JQIamo/AOD_protector/AOD_protector-main/AOD_protector-main.kicad_pcb

## KiCad design AOD_protector-main/AOD_protector-main.kicad_pcb (2025-11-24)

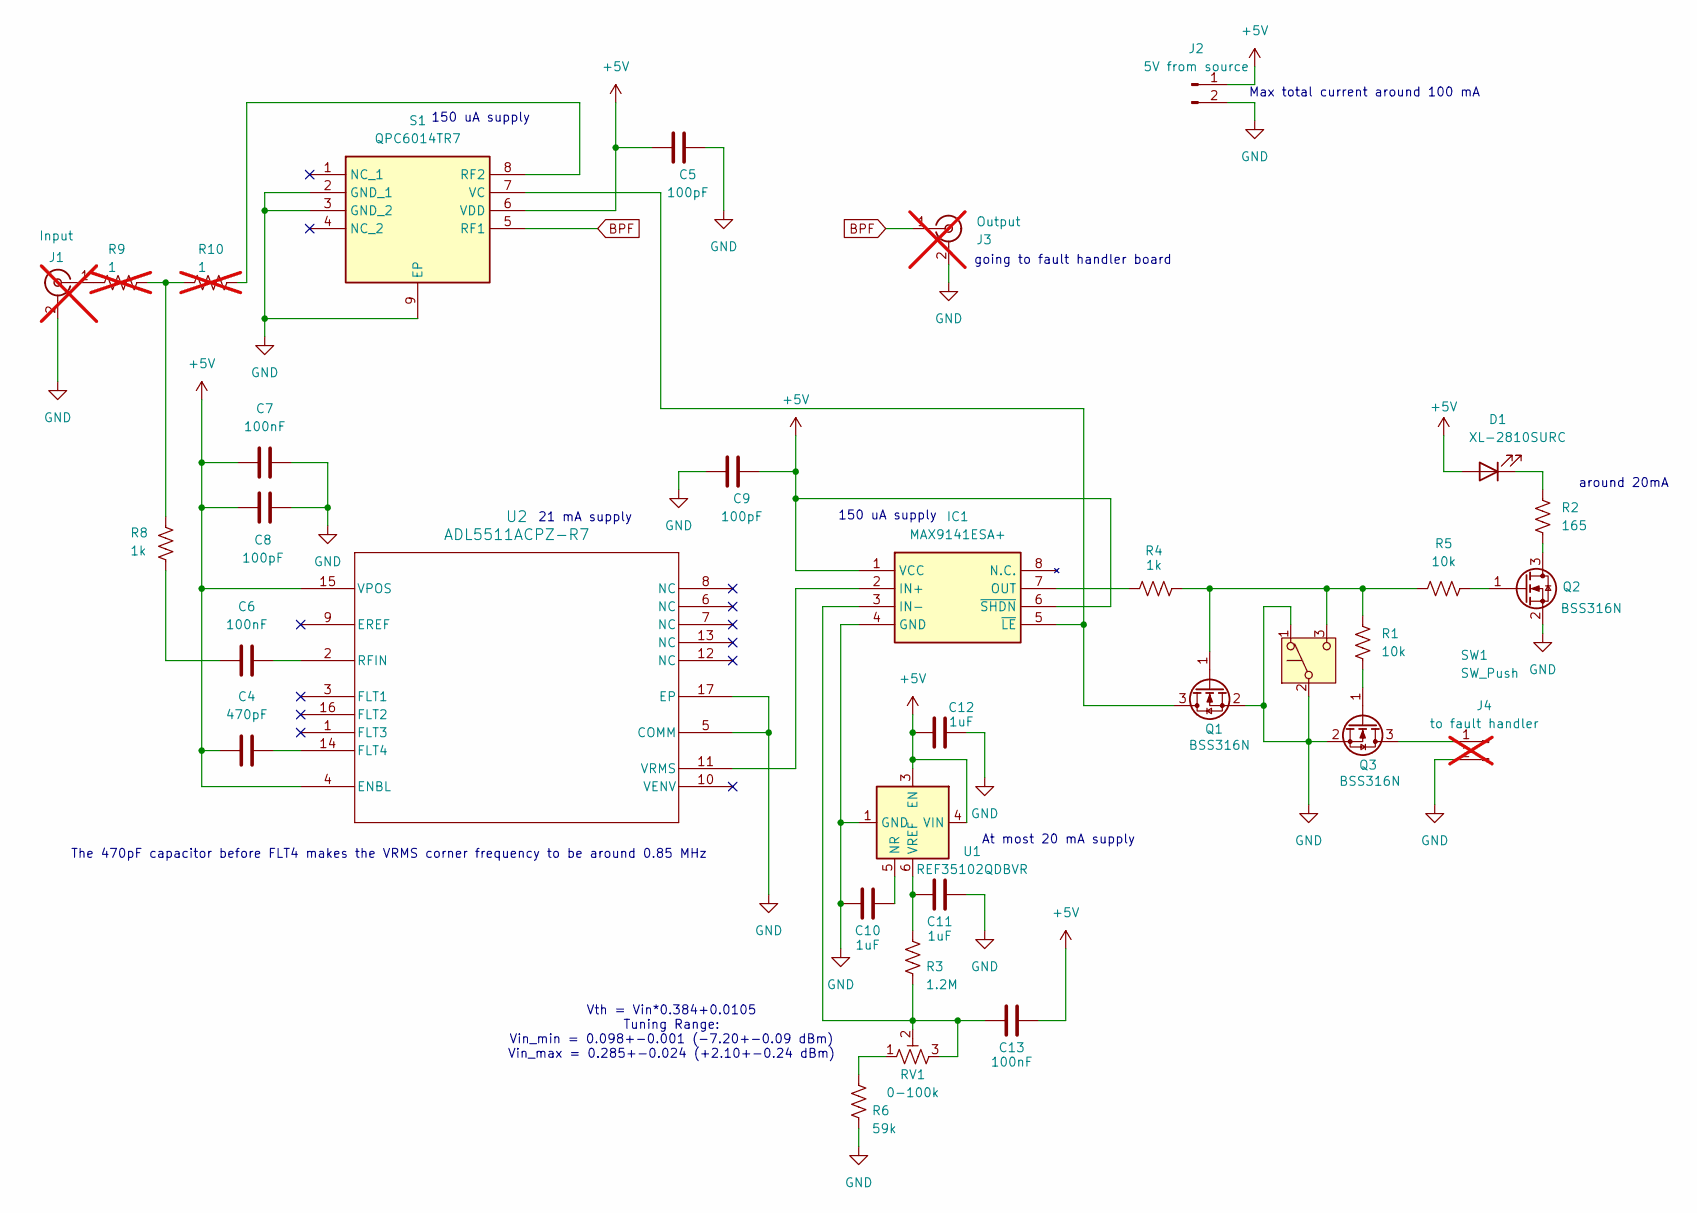
[picture p5: schematic AOD_protector-main.kicad_sch]

Parts:
C4: 470pF; C_0402_1005Metric; Part number CC0402FRNPO9BN471; JLCPCB Part C513551
C5, C8, C9: 100pF; C_0402_1005Metric; Part number CC0402FRNPO9BN101; JLCPCB Part C327198
C6, C7, C13: 100nF; C_0603_1608Metric; Part number CC0603JRX7R9BB104; JLCPCB Part C91183
C10, C11, C12: 1uF; C_0603_1608Metric; Part number CL10B105KB8NQNC; JLCPCB Part C5199872
D1: XL-2810SURC; LED-SMD_L3.5-W1.4-FD-1; Part number XL-2810SURC; JLCPCB Part C3646948
IC1: MAX9141ESA+; SOIC127P600X175-8N; Manufacturer_Part_Number MAX9141ESA+; Mouser Part Number 700-MAX9141ESA
J1: Input; BNC_Amphenol_031-6233_EdgeMount; Part number 031-6233; not fitted
J2: 5V from source; CONN-TH_2P-P2.54_MX128-2.54-GN01-02P-CU-Y-A; Part number MX128-2.54-02P-GN01-Cu-Y-A; JLCPCB Part C5188442
J3: Output; BNC_Amphenol_031-6233_EdgeMount; Part number 031-6233; not fitted
J4: to fault handler; PinHeader_1x02_P2.54mm_Vertical; not fitted
Q1, Q2, Q3: BSS316N; SOT-23; Part number BSS316N; JLCPCB Part C19829413
R1, R5: 10k; R_0402_1005Metric; Part number RT0402BRD0710KL; JLCPCB Part C190095
R2: 165; R_0603_1608Metric; Part number ARG03BTC1650; JLCPCB Part C5266122
R3: 1.2M; R_0603_1608Metric; Part number MCT0603MD1204BP500; JLCPCB Part C3933664
R4, R8: 1k; R_0402_1005Metric; Part number RT0402BRD071KL; JLCPCB Part C852624
R6: 59k; R_0402_1005Metric; Part number RT0402BRD0759KL; JLCPCB Part C852853
R9, R10: 1; R_0402_1005Metric; not fitted
RV1: 0-100k; RES-ADJ-TH_3296X; Part number 3296X-1-104LF; JLCPCB Part C49473
S1: QPC6014TR7; SON50P200X200X90-9N-D; Manufacturer_Part_Number QPC6014TR7; Mouser Part Number 772-QPC6014TR7
SW1: SW_Push; SW-TH_TK-6580B-2; Part number TK-6580B-2; JLCPCB Part C2689830
U1: REF35102QDBVR; SOT-23-6; Part number REF35102QDBVR; JLCPCB Part C6265001
U2: ADL5511ACPZ-R7; CP_16_22_ADI; Part number ADL5511ACPZ-R7; JLCPCB Part C579159

Connections:
+5V: C4.1, C5.1, C7.1, C8.1, C9.2, C12.2, C13.1, D1.2 (A), IC1.1 (VCC), IC1.6 (~SHDN), J2.1, S1.6 (VDD), U1.3 (EN), U1.4 (VIN), U2.4 (ENBL), U2.15 (VPOS)
BPF: J3.1 (In), S1.5 (RF1)
GND: C5.2, C7.2, C8.2, C9.1, C10.2, C11.1, C12.1, IC1.4 (GND), J1.2 (Ext), J2.2, J3.2 (Ext), J4.2, Q1.2 (S), Q2.2 (S), Q3.2 (S), R6.1, S1.2 (GND_1), S1.3 (GND_2), S1.9 (EP), SW1.1 (A), SW1.2 (B), U1.1 (GND), U1.2 (GND), U2.5 (COMM), U2.17 (EP)
unnamed: C6.1, R8.1
unnamed: D1.1 (K), R2.1
unnamed: IC1.2 (IN+), U2.11 (VRMS)
unnamed: C13.2, IC1.3 (IN-), R3.1, RV1.2, RV1.3
unnamed: IC1.7 (OUT), R4.1
unnamed: IC1.5 (~LE), Q1.3 (D), S1.7 (VC)
unnamed: J1.1 (In), R9.1
unnamed: J4.1, Q3.3 (D)
unnamed: Q1.1 (G), R1.1, R4.2, R5.2, SW1.3 (C)
unnamed: Q2.3 (D), R2.2
unnamed: Q2.1 (G), R5.1
unnamed: Q3.1 (G), R1.2
unnamed: R6.2, RV1.1
unnamed: R8.2, R9.2, R10.1
unnamed: R10.2, S1.8 (RF2)
unnamed: C10.1, U1.5 (NR)
unnamed: C11.2, R3.2, U1.6 (VREF)
unnamed: C4.2, U2.14 (FLT4)
unnamed: C6.2, U2.2 (RFIN)

Notes on the sheet:
At most 20 mA supply
21 mA supply
150 uA supply
Vth = Vin*0.384+0.0105 Tuning Range: Vin_min = 0.098+-0.001 (-7.20+-0.09 dBm) Vin_max = 0.285+-0.024 (+2.10+-0.24 dBm)
around 20mA
going to fault handler board
Max total current around 100 mA
The 470pF capacitor before FLT4 makes the VRMS corner frequency to be around 0.85 MHz

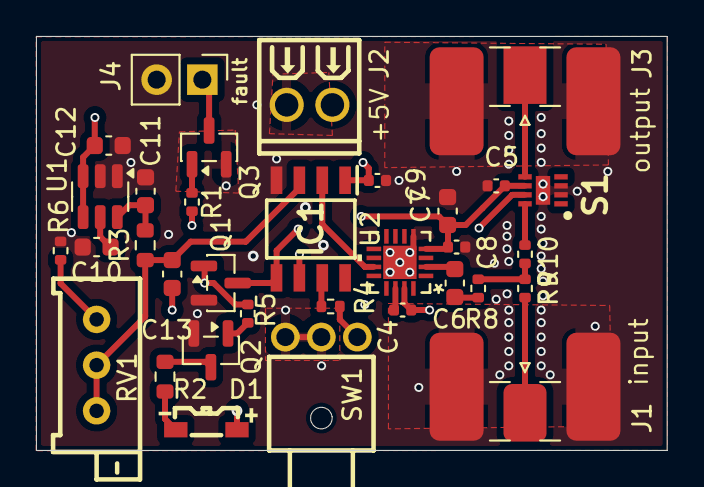
[picture p6: board AOD_protector-main.kicad_pcb from above]

Board: 4 copper layers, 35.0 x 23.0 mm, 33 parts (0 on the bottom side), 22 nets.
