JQIamo/AOD_protector/AOD_protector-fault_handler/AOD_protector-fault_handler.kicad_pcb

## KiCad design AOD_protector-fault_handler/AOD_protector-fault_handler.kicad_pcb (2025-11-17)

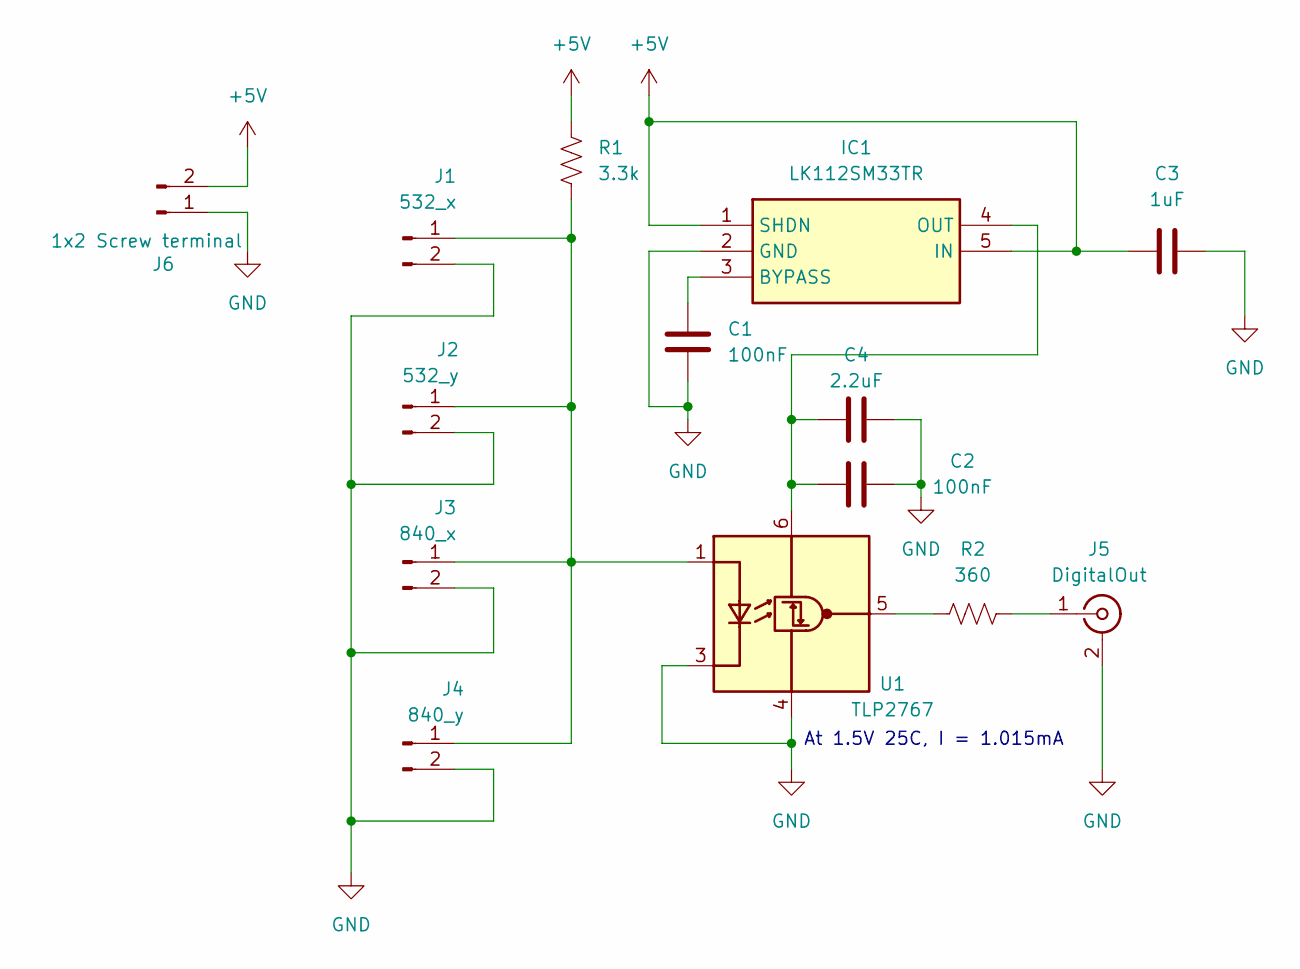
[picture p7: schematic AOD_protector-fault_handler.kicad_sch]

Parts:
C1, C2: 100nF; C_0603_1608Metric
C3: 1uF; C_0805_2012Metric
C4: 2.2uF; C_0805_2012Metric
IC1: LK112SM33TR; SOT95P280X145-5N; Mouser Part Number 511-LK112SM33
J1: 532_x; PinHeader_1x02_P2.54mm_Vertical
J2: 532_y; PinHeader_1x02_P2.54mm_Vertical
J3: 840_x; PinHeader_1x02_P2.54mm_Vertical
J4: 840_y; PinHeader_1x02_P2.54mm_Vertical
J5: DigitalOut; BNC_Amphenol_031-6233_EdgeMount; Manufacturer_Part_Number 031-6233
J6: 1x2 Screw terminal; CONN-TH_2P-P2.54_MX128-2.54-GN01-02P-CU-Y-A
R1: 3.3k; R_0603_1608Metric
R2: 360; R_0603_1608Metric
U1: TLP2767; SO-6L_10x3.84mm_P1.27mm; Manufacturer_Part_Number TLP2767

Connections:
+5V: C3.1, IC1.1 (SHDN), IC1.5 (IN), J6.2, R1.1
GND: C1.2, C2.2, C3.2, C4.2, IC1.2 (GND), J1.2, J2.2, J3.2, J4.2, J5.2 (Ext), J6.1, U1.3 (K), U1.4 (GND)
unnamed: C1.1, IC1.3 (BYPASS)
unnamed: C2.1, C4.1, IC1.4 (OUT), U1.6 (VDD)
unnamed: J1.1, J2.1, J3.1, J4.1, R1.2, U1.1 (A)
unnamed: J5.1 (In), R2.2
unnamed: R2.1, U1.5 (VO)

Notes on the sheet:
At 1.5V 25C, I = 1.015mA

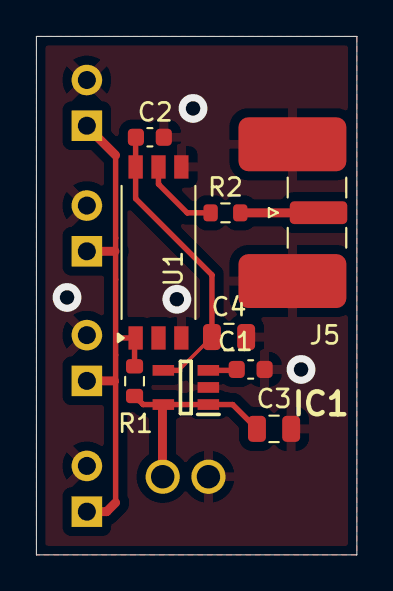
[picture p8: board AOD_protector-fault_handler.kicad_pcb from above]

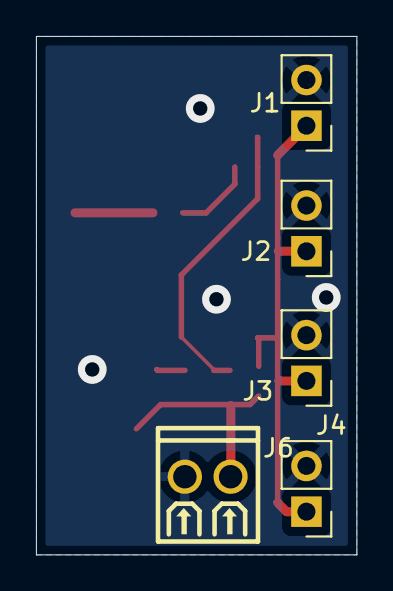
[picture p9: board AOD_protector-fault_handler.kicad_pcb from below]

Board: 2 copper layers, 17.8 x 28.8 mm, 14 parts (5 on the bottom side), 7 nets.
