JQIamo/AOD_protector/AOD_protector-power_board/AC_supply_module.kicad_pcb

## KiCad design AOD_protector-power_board/AC_supply_module.kicad_pcb (2025-11-17)

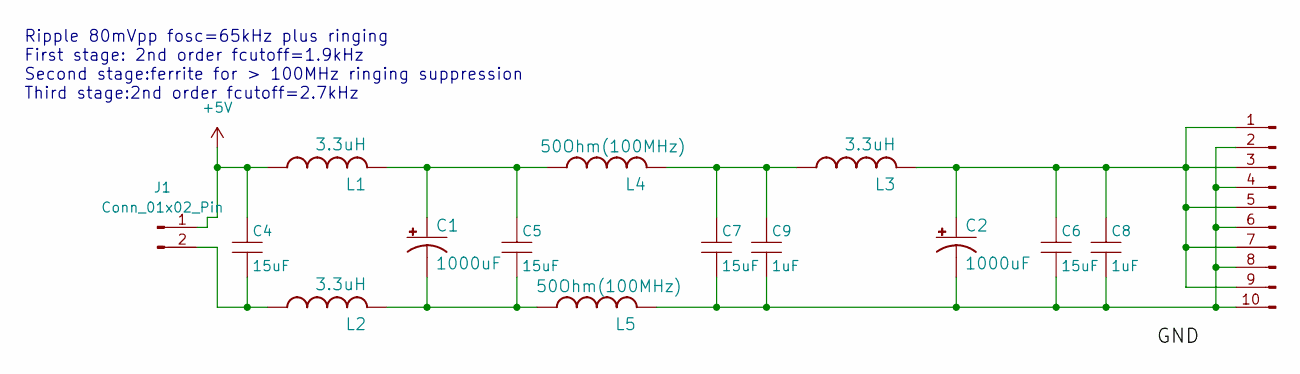
[picture p10: schematic AC_supply_module.kicad_sch]

Parts:
C1, C2: 1000uF; E3,5-8; PARTNO APSG160ELL102MH20S; DIGIKEY 565-4311-ND
C4, C5, C6, C7: 15uF; C_MLCC_0805; PARTNO C2012JB1E156M125AC; DIGIKEY 445-11470-1-ND
C8, C9: 1uF; C_MLCC_0306; PARTNO C0816X5R1C105M050AC; DIGIKEY 445-13750-1-ND
J1: Conn_01x02_Pin; TerminalBlock_Phoenix_PT-1,5-2-3.5-H_1x02_P3.50mm_Horizontal; Manufacturer_Part_Number DB301V-3.5-2P-GN-S
J2: Conn_01x08_Pin; TerminalBlock_Phoenix_PT-1,5-10-3.5-H_1x10_P3.50mm_Horizont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; Manufacturer_Part_Number DB125-3.5-8P-GN-S
L1, L2, L3: 3.3uH; L-322X322; PARTNO IHLP3232DZER3R3M11; DIGIKEY 541-1352-1-ND
L4, L5: 50Ohm(100MHz); C1206; PARTNO BLM31SN500SN1L; DIGIKEY 490-13269-1-ND

Connections:
+5V: C4.P$1 (1), J1.1, L1.P$1 (1)
unnamed: C4.P$2 (2), J1.2, L2.P$1 (1)
unnamed: C1.+, C5.P$1 (1), L1.P$2 (2), L4.1
unnamed: C1.-, C5.P$2 (2), L2.P$2 (2), L5.1
unnamed: C2.+, C6.P$1 (1), C8.P$1 (1), J2.1, J2.3, J2.5, J2.7, J2.9, L3.P$2 (2)
unnamed: C2.-, C6.P$2 (2), C7.P$2 (2), C8.P$2 (2), C9.P$2 (2), J2.2, J2.4, J2.6, J2.8, J2.10, L5.2
unnamed: C7.P$1 (1), C9.P$1 (1), L3.P$1 (1), L4.2

Notes on the sheet:
Ripple 80mVpp fosc=65kHz plus ringing First stage: 2nd order fcutoff=1.9kHz Second stage:ferrite for > 100MHz ringing suppression Third stage:2nd order fcutoff=2.7kHz

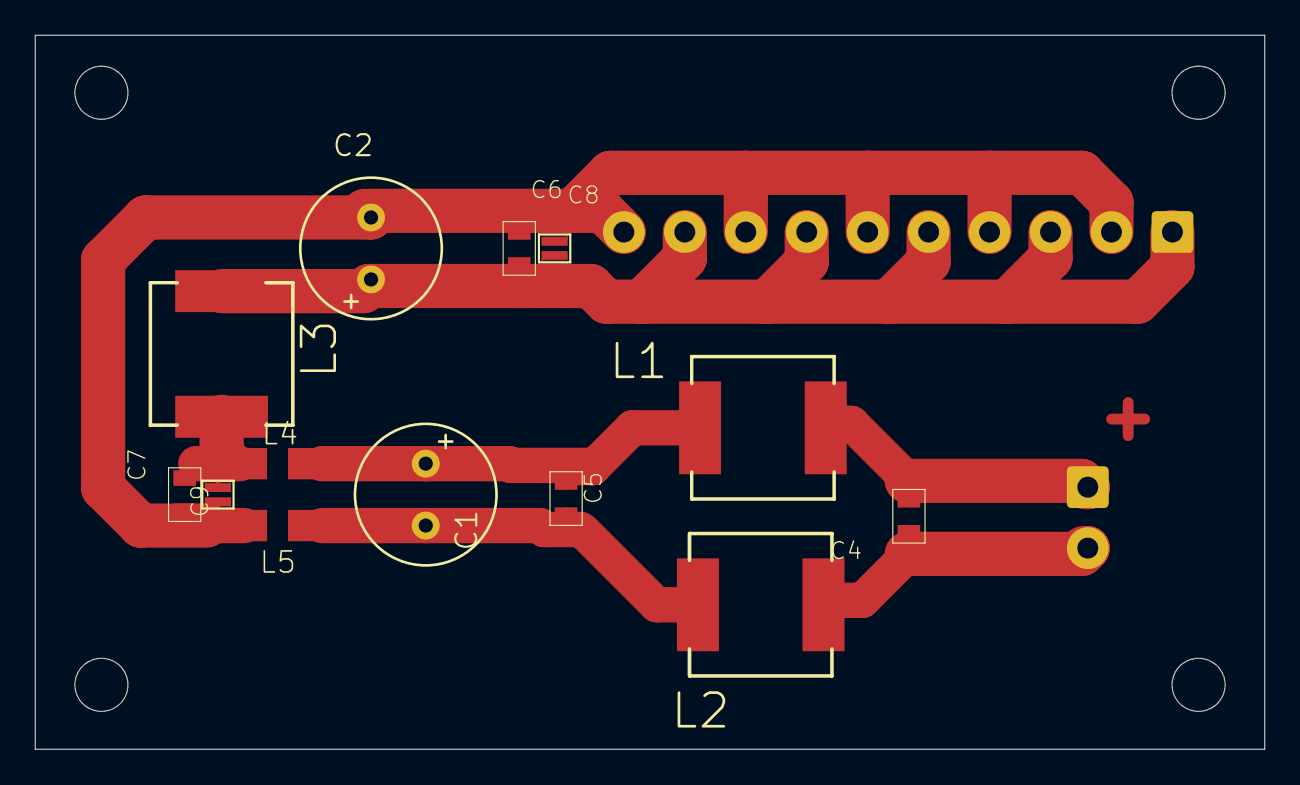
[picture p11: board AC_supply_module.kicad_pcb from above]

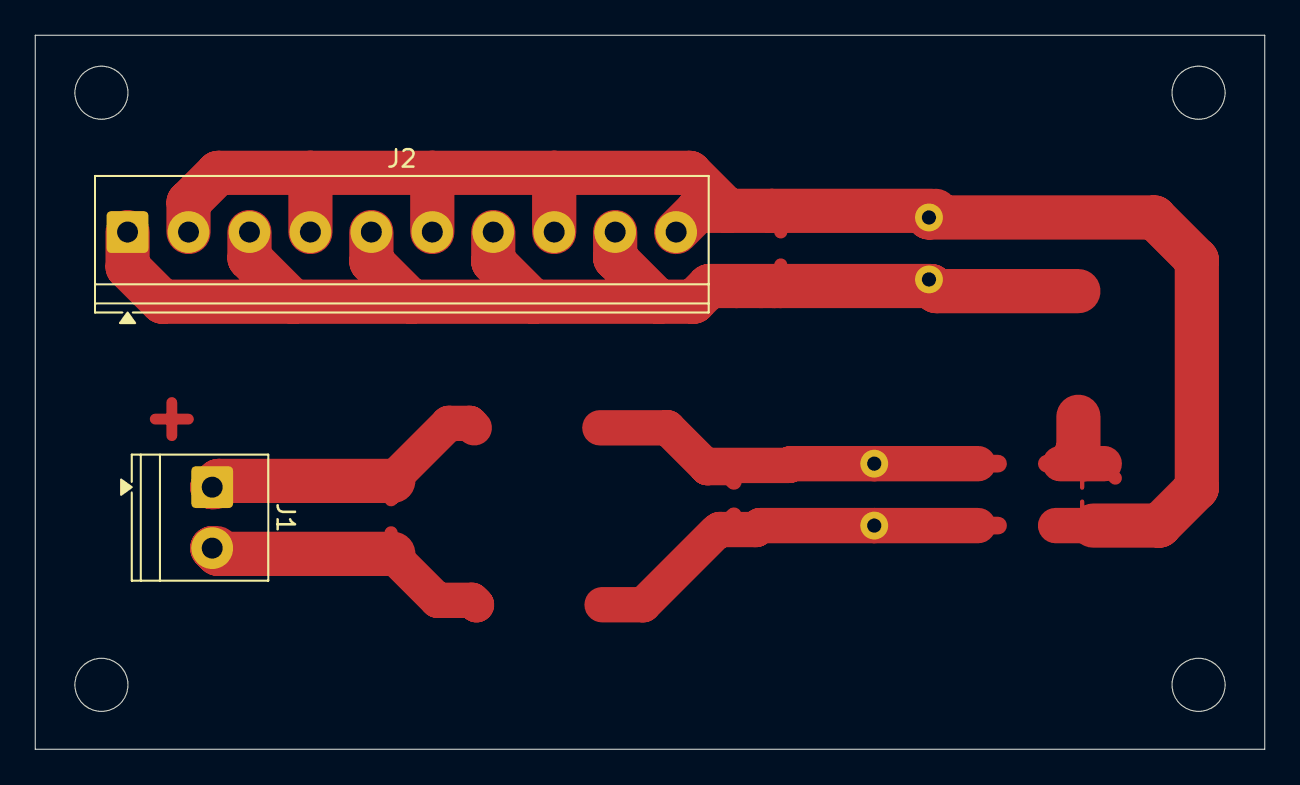
[picture p12: board AC_supply_module.kicad_pcb from below]

Board: 2 copper layers, 70.6 x 41.0 mm, 17 parts (2 on the bottom side), 7 nets.

Other parts of the board:
@HOLE1, @HOLE2: (no value)
