JQIamo/AOD_protector/AOD_protector-BPF_testboard/840Test_board/840Test_board.kicad_pcb

## KiCad design AOD_protector-BPF_testboard/840Test_board/840Test_board.kicad_pcb (2025-11-17)

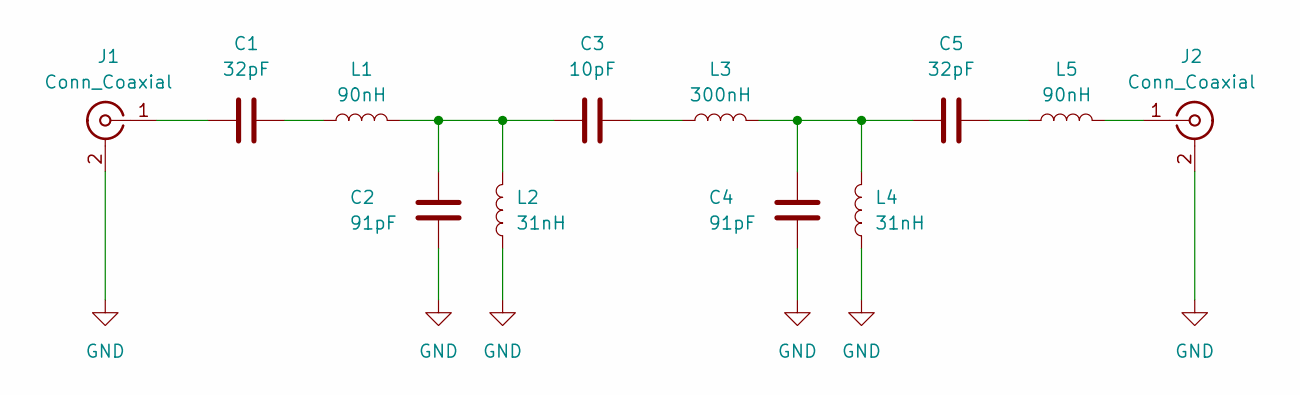
[picture p13: schematic 840Test_board.kicad_sch]

Parts:
C1, C5: 32pF; C_0603_1608Metric; Part Number 06031A320FAT2A
C2, C4: 91pF; C_0402_1005Metric; Part Number GRT1555C1H910FA02D
C3: 10pF; C_0402_1005Metric; Part Number 04025U100BAT2A
J1, J2: Conn_Coaxial; BNC_Amphenol_031-6233_EdgeMount; Part Number 031-6233
L1, L5: 90nH; AC1060R90NG; Part Number AC1060R-90NG
L2, L4: 31nH; L_0603_1608Metric; Part Number LQW18AN31NG8ZD
L3: 300nH; 2222SQ301GEC; Part Number 2222SQ301GEC

Connections:
GND: C2.1, C4.1, J1.2 (Ext), J2.2 (Ext), L2.1, L4.1
unnamed: C1.2, L1.1
unnamed: C2.2, C3.1, L1.2, L2.2
unnamed: C3.2, L3.1
unnamed: C4.2, C5.1, L3.2, L4.2
unnamed: C5.2, L5.1
unnamed: C1.1, J1.1 (In)
unnamed: J2.1 (In), L5.2

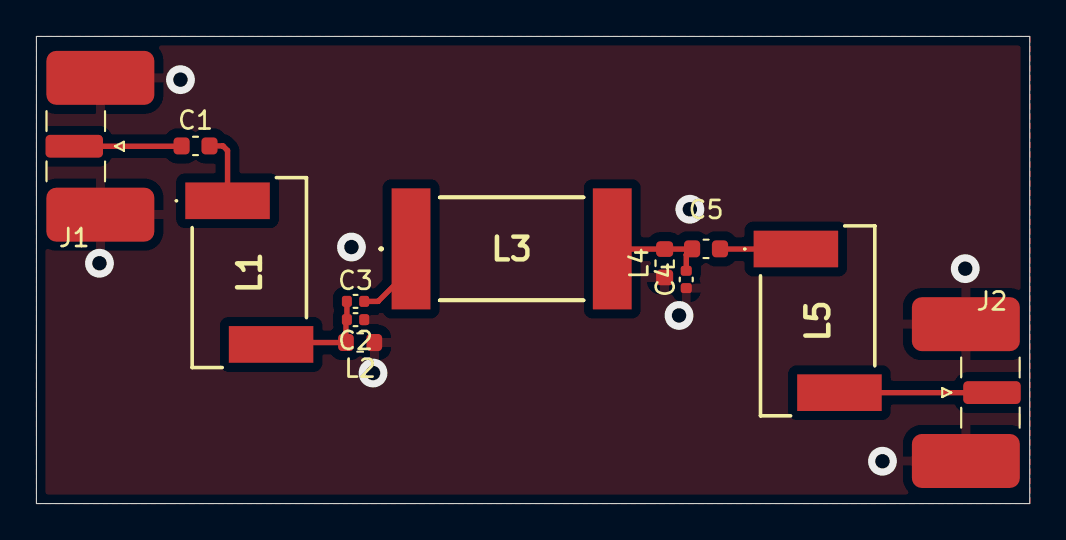
[picture p14: board 840Test_board.kicad_pcb from above]

Board: 2 copper layers, 55.2 x 26.0 mm, 12 parts (0 on the bottom side), 8 nets.
