JQIamo/AOD_protector/AOD_protector-BPF_testboard/532Test_board/qucs/532.png

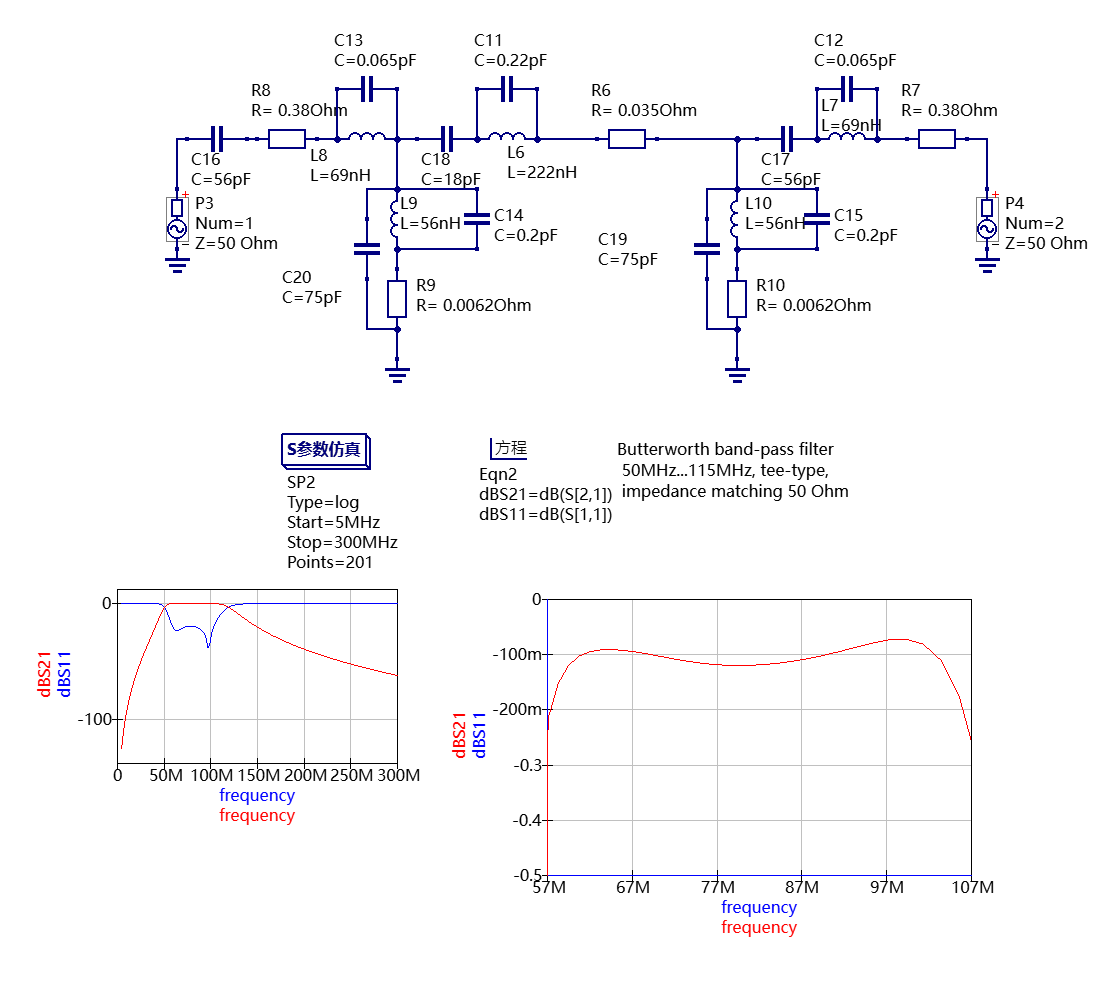
AOD_protector-BPF_testboard/532Test_board/qucs/532.png
