JQIamo/AOD_protector/AOD_protector-BPF_testboard/840Test_board/qucs/840.png

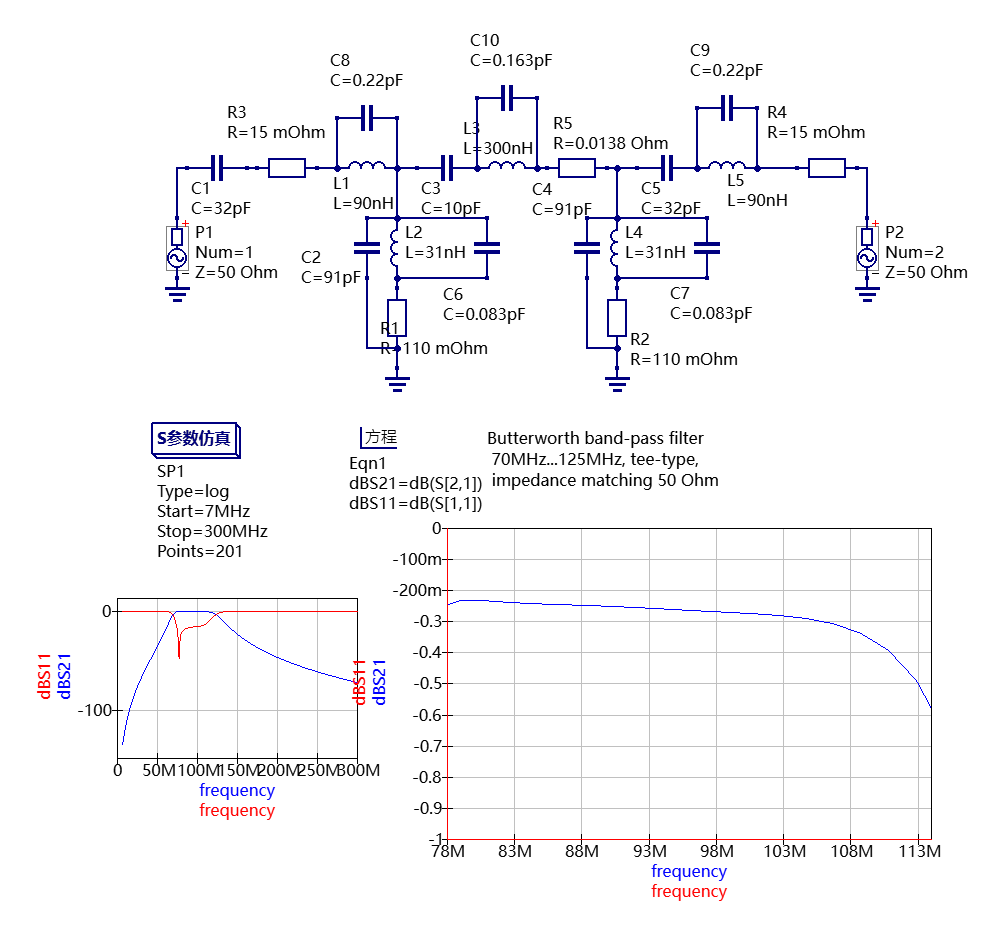
AOD_protector-BPF_testboard/840Test_board/qucs/840.png
