JQIamo/AOD_protector/(commit log)

2025-11-24 Fixed a resistor value bug
2025-12-09 Update with the rack-mount box designs
